ut-robotics/picr22-team-teletupsud/(threads)

Thread 2 (2022-09-19):

[Mechanics] Use circle or arc for slide C-ramp

maidlam, 2022-09-19:
Do not use a spline for the C-ramp of the slide. Use a circle or arc, with its center set on the center of the motor.

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

KaarelJ98, 2022-09-21:
Resolved

Closed 2022-09-24.

Thread 3 (2022-09-19):

[Mechanics] Add wheels and top plate to assembly

maidlam, 2022-09-19:
Add the wheels and top plate to the model so the distance from the floor to the thrower motor and ramps can be checked.

KaarelJ98, 2022-09-22:
Resolved

Closed 2022-09-24.

Thread 5 (2022-09-19):

[Mechanics] Wrong material thickness for slides

maidlam, 2022-09-19:
The slides should be 4,8 mm thick.

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

KaarelJ98, 2022-09-21:
Resolved

Closed 2022-09-24.

Thread 7 (2022-09-25):

[Mechanics] mounting hole size wrong

Akustav, 2022-09-25:
Mounting holes are currently 3mm. They should be 2.5mm

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

KaarelJ98, 2022-09-25:
Resolved

Thread 8 (2022-09-25):

[Mechanics] bottom plate-thrower mating weird

Akustav, 2022-09-25:
Seems like there is some interference between the thrower tabs and the thower:

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

It also seems that the mounting holes are weirdly placed and not centered:
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

KaarelJ98, 2022-09-25:
Resolved

Closed 2022-10-17.

Thread 9 (2022-09-29):

[Mechanics] Test thrower CAM issues

maidlam, 2022-09-29:
Drill:

- Remove dogbones from drill operation

2D Contour

- Under the Passes tab, add Stock to leave based on Pocket part of guide
https://ut-robotics.github.io/picr22-home/basketball_robot_guide/mechanics/cam.html#_pocket
- Under Linking tab, untick Ramp

Closed 2022-12-04.

Thread 11 (2022-10-17):

[Mechanics] add lips for better roller centering

Akustav, 2022-10-17:
I suggest adding lips to the sides of the slots where rollers are. This fixes them better in place.
One thing to keep in mind is that they should only touch the inner sleeve of the bearing since it is static, if it touches other areas, it can

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

KaarelJ98, 2022-10-24:
Resolved

Closed 2022-11-30.

Thread 12 (2022-10-17):

[Mechanics] Wheel screw question

Akustav, 2022-10-17:
Depending on if you plan to cover the wheels or not I suggest using countersunk screw heads. This reduces the chance of damaging opponents or the field with the screwheads.

KaarelJ98, 2022-10-24:
I haven't decided yet if I plan to cover the wheels or not but if not then I will use countersunk screw heads.

Closed 2022-11-30.

Thread 13 (2022-10-17):

[Mechanics] motor-wheel mount issues

Akustav, 2022-10-17:
I suggest making the mount a little thinner.

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

I would make the threaded parts (marked with number 1) around 3mm and the upper part around 8 mm.

Also, the holes in the mount should be 2.5mm instead of 3 since they are threaded.

What screw do you plan to use to fasten the wheel to the motor shaft?

KaarelJ98, 2022-10-24:
Resolved
I was planning to use M4x6 or M4x8 screw.

Closed 2022-11-30.

Thread 14 (2022-10-17):

[Mechanics] add hole for shaft in wheel body

Akustav, 2022-10-17:
Consider adding a hole to the wheel body where the shaft can go. This allows to you more adaptability on where the wheel sits on the shaft.

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

KaarelJ98, 2022-10-24:
Resolved

Closed 2022-11-30.

Thread 16 (2022-10-19):

MCU encoder pins assigned incorrectly

ReikoR, 2022-10-19:
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

PA8 and PA9 are connected to timer 1.
M1_ENC_2 should be connected to PA9 instead of PB7.

PB0 does not have any timer channels that can be used in encoder mode.
For example timer 4 and pins PB6 and PB7 could be used for one of the encoders.

ReikoR, 2022-11-19:
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

Rechecked the pin assignment. PB0 does not have any encoder inputs available (timer channel 1 or 2).

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

Thread 17 (2022-10-19):

Incorrect NRST capacitor value

ReikoR, 2022-10-19:
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

1K(F?) is not a correct value for a 0603 capacitor.
It should probably be 100n.

Closed 2022-10-29.

Thread 23 (2022-10-19):

CM1223 in incorrect package

ReikoR, 2022-10-19:
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

CM1223-**02SR** is in SOT143-4 package.

In the lab we have CM1223-**02SO**, which is in SOT23-5 package.

From [datasheet](https://www.onsemi.com/pdf/datasheet/cm1223-d.pdf):
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

Closed 2022-10-29.

Thread 24 (2022-10-19):

DRV8243 incorrect current limiting

ReikoR, 2022-10-19:
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

From [datasheet](https://ut-robotics.github.io/picr22-home/basketball_robot_guide/electronics/drv8243-q1_datasheet_2021-08.pdf):
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

When ITRIP pin is connected to ground, then current regulation is disabled.

Current limit should be set to around 2-3A to help prevent motor from overheating. IPROPI resistor value should be calculated based on that.

ReikoR, 2022-10-29:
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

Connecting ITRIP pin to 100k resistor sets ITRIP voltage to 2.64 V:
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

Using 10k IPROPI resistor sets current limit to 2.64 V / 10000 ohm * 3070 = 0.81 A, which might be too low to accelerate the motor under load.

Also connecting 100k resistor to SR pin sets the slew rate to highest value:
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

This can't be read form the datasheet, but highest slew rate caused problems last year with motors not starting or rotating properly. Using slew rates of 23 or 28 V/usec worked fine.

Closed 2022-11-02.

Thread 25 (2022-10-19):

Use 4 layers instead of 2

ReikoR, 2022-10-19:
4 layer PCB with both inner layers being grounds is much better for signal integrity.

If there are gaps in ground (or any other reference layer), then return currents have to go around the gaps and electromagnetic fields will spread out more causing more crosstalk.

Also, if distance between signal and reference plane is bigger then fields will spread out more and cause more crosstalk.
In 4-layer PCB, distances between layers 1-2 and 3-4 are usually small (0.2mm or less).

More detailed design advice:
https://www.protoexpress.com/blog/best-high-speed-pcb-routing-practices/

Also, from JLCPCB both 2-layer and 4-layer PCBs up to 50x50mm size cost the same.

ReikoR, 2022-10-29:
Internal planes need to be split to separate MCU side from drivers side. Nets need to assigned to planes.

This short video can be helpful:
https://youtu.be/1XJzsImG-bo?t=70

ReikoR, 2022-11-12:
Correct nets have not been assigned to split planes:
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

ReikoR, 2022-11-16:
PGND net needs to be selected on motor drivers side:
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

And GND net on MCU side:
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

Closed 2022-11-18.

Thread 26 (2022-10-19):

Keep isolated sides completely separate

ReikoR, 2022-10-19:
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

There should be separate grounds on MCU side and drivers side.

General layout should look something like this:
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

ReikoR, 2022-10-29:
MCU side components need to be moved to other side of the board and internal planes need to be split below the isolators.
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

Closed 2022-11-12.

Thread 27 (2022-10-29):

Thrower PWM should go through isolator

ReikoR, 2022-10-29:
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

Motor driver DRVOFF pin can be connected to GND to have driver constantly enabled, instead of connecting it to MCU. Then additional isolator is not needed for thrower PWM.

Thread 29 (2022-10-29):

Use wide polygons or tracks for high currents

ReikoR, 2022-10-29:
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

0.254 mm wide traces can carry about 1.7 A of current at 20 degrees temperature rise:
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

Wider copper helps to carry more current and more copper helps with cooling.

ReikoR, 2022-11-02:
Use wide polygons for higher currents.
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

ReikoR, 2022-11-12:
1. GND pad should also be connected with multiple vias.
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

2. Use "Pour Over All Same Net Objects" in polygon properties.
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
\
And check "Remove Dead Copper".
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

3. Remove vias from motor driver footprint. Vias should not be added to footprints. Currently in motor driver output pads they are not needed. Add vias manually to VM and GND pads after removing them from the footprint.
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

4. Some motor driver capacitors are not connected to PGND.
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

5. Put all the motor driver capacitors in a single row.
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
Something like this:
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

6. Route as much as possible on top layer to prevent making big gaps in 16V polygon.
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

7. Connect capacitor ground pads with PGND polygon on bottom layer.
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

ReikoR, 2022-11-18:
1. Connect motor driver +16V and PGND pads with multiple vias. One via can carry roughly 1 A of current.
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

2. Motor driver output polygons are not aligned with the pads.
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

3. Place smaller capacitors closest to the motor drivers.
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

4. Connect PGND polygon on bottom layer to battery PGND pad vias.
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

ReikoR, 2022-11-19:
Try to place vias more evenly. All the vias don't have to be in the capacitor pads.
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

For example:
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

You can use `Ctrl + Arrow` to move selected items by grid step or `Ctrl + Shift + Arrow` to move them by 10x grid step.

Closed 2022-11-19.

Thread 30 (2022-10-29):

Use smaller vias

ReikoR, 2022-10-29:
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

Smaller vias take less space.
JLCPCB minimum via size is 0.2/0.45 mm.
For higher currents use multiple small vias.

ReikoR, 2022-11-12:
Some vias have the same Diameter and Hole Size:
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

Closed 2022-11-18.

Thread 31 (2022-10-30):

Mounting holes

ReikoR, 2022-10-30:
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

What size screws are you planning to use for attaching the PCB?
2.6mm hole would allow M2.5 or M2 screws to be used, but it might be better to use M3 screws and make the holes bigger.

Holes might be too close for components and tracks. Depending on the screws, they might not fit or might damage tracks on the PCB.
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

ReikoR, 2022-11-02:
Mounting holes are still close to tracks and components:
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

ReikoR, 2022-11-12:
Bottom left hole is a bit too close to motor driver output pad:
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

ReikoR, 2022-11-18:
Don't connect mounting holes to any nets.
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

And don't use plating:
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

ReikoR, 2022-11-19:
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

Bottom right hole is not on 1 mm grid.

Also it might be useful to have holes positioned symmetrically. Right now the y-direction spacing is different from x-direction spacing:
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

ReikoR, 2022-11-19:
If spacers are going to be used then the capacitors at the bottom are too close to the mounting holes.
Capacitors should be moved slightly inwards.

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

Closed 2022-11-19.

Thread 33 (2022-10-30):

0603 package for 10u 25V+ capacitors too small

ReikoR, 2022-10-30:
10u 25V 0603 capacitors exist, but are more expensive. 0805 package size would be better.

Thread 35 (2022-10-30):

Place decoupling capacitors as close as possible to power pins

ReikoR, 2022-10-30:
Capacitors should have shortest possible connection to power pins to reduce inductance. Placing capacitors on the same layer as the component also allows for shorter connection.

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

ReikoR, 2022-11-02:
Decoupling capacitors are still not close to the power pins.

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

ReikoR, 2022-11-12:
100 nF capacitors should be next to the power pins, 4.7uF capacitor can be a bit further away.
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

Closed 2022-11-16.

Thread 36 (2022-11-12):

Use JLC7628 stackup

ReikoR, 2022-11-12:
Use JLC7628 stackup instead of JLC3313 as it is cheaper.

USB differential pair trace width and spacing needs to be changed.

For example 8 mil (about 0.2 mm) trace space and 10.28 mil (about 0.26 mm) trace width would work:
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

ReikoR, 2022-11-18:
Try to make tracks straighter:
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

ReikoR, 2022-11-19:
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

I'm not sure if it is actually better, but it aligns with the recommendations/example layouts:

Example layout of ESD protection component with same pinout as CM1223-02SO:
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

Image taken from here:
https://www.we-online.com/catalog/media/o109030v410%20AppNotes_ANP002_TheProtectionOfUSB20Applications_EN.pdf

In theory there be might some coupling between same signal track segments or the ESD spike might jump the gap.
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

Closed 2022-11-19.

Thread 37 (2022-11-12):

Incorrect voltage regulator footprint

ReikoR, 2022-11-12:
NCP164CSN330T1G:
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

NCV8730ASN500T1G
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

From NCP164 datasheet:
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

ReikoR, 2022-11-16:
3D model is misaligned:
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

Closed 2022-11-18.

Thread 38 (2022-11-12):

Create Board Outline Clearance rule

ReikoR, 2022-11-12:
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

Closed 2022-11-16.

Thread 39 (2022-11-12):

Prefer tented vias

ReikoR, 2022-11-12:
Untented vias can cause shorts or soldering problems in some cases.

Simplest way to use tented vias is to create new Solder Mask Expansion rule:
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

Closed 2022-11-16.

Thread 40 (2022-11-12):

Voltage regulators have EN pins incorrectly connected

ReikoR, 2022-11-12:
1. NCP164:
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
\
Capacitor (C1) must be connected to IN and GND pins.
EN pin must be connected to IN pin to enable the regulator.
\
From [NCP164 datasheet](https://www.onsemi.com/pdf/datasheet/ncp164-d.pdf):
**EN** - Chip enable: Applying V<sub>EN</sub> < 0.2 V disables the regulator, Pulling V<sub>EN</sub> > 0.7 V enables the LDO

2. NCV8730
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
\
Capacitor (C27) must be connected to IN and GND pins.
EN pin must be connected to IN pin or left unconnected to enable the regulator.
Connecting EN pin to IN pin is recommended for compatibility with other regulators.
\
From [NCV8730 datasheet](https://www.onsemi.com/pdf/datasheet/ncv8730-d.pdf):
**EN** - Enable input pin (high − enabled, low − disabled). If this pin is connected to IN pin or if it is left unconnected (pull−up resistor is not required) the device is enabled.

ReikoR, 2022-11-16:
GND is not connected to NCP164:
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

Closed 2022-11-18.

Thread 42 (2022-11-12):

USB connector might be too far away from the edge

ReikoR, 2022-11-12:
PCB edge is marked on the footprint:
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

There is no 3D model on the footprint, so it's hard to say if the connector will collide with the PCB.

From [connector drawing](https://cdn.amphenol-cs.com/media/wysiwyg/files/drawing/10118193.pdf):
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

Closed 2022-11-16.

Thread 43 (2022-11-12):

MCU 3D model is not correctly placed on the footprint

ReikoR, 2022-11-12:
From top of the PCB:
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

From bottom of the PCB:
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

Closed 2022-11-16.

Thread 45 (2022-11-18):

Avoid routing +3V3 on top layer

ReikoR, 2022-11-18:
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

There is a +3V3 polygon on bottom layer.

Connect +3V3 on top layer with vias to polygon on bottom layer, instead of routing it on the top layer.

ReikoR, 2022-11-19:
Place vias closer to components. Capacitors could also be closer.

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

Closed 2022-11-19.

Thread 47 (2022-11-18):

Improve routing

ReikoR, 2022-11-18:
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

Gloss Selected functionality might be useful:
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

Make sure that the tracks to not get too close to each other to prevent noise caused by adjacent tracks.

ReikoR, 2022-11-19:
Try to clean up the layout as much as possible.
Place vias and and capacitors close to components.
Make tracks short and straight.
Keep the space between tracks to prevent signals coupling to adjacent tracks and causing crosstalk.
Try to avoid tracks crossing each other and having to use vias to route across tracks.

For example:
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

It would be better to route nSLEEP track away from high current connections to reduce noise.
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

ReikoR, 2022-11-19:
Some vias can be closer to components.
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

Closed 2022-11-19.

Thread 48 (2022-11-19):

Number and label connectors

ReikoR, 2022-11-19:
It would be useful to number encoder connectors similar to motor drivers and label the other connectors.

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

ReikoR, 2022-11-19:
Increase the text height to  make it readable.
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

Also using Arial font results in lower text height. Text Height parameter needs to be increased to compensate.
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

Try to follow JLCPCB recommendations:
> Minimum Line Width 6 mil (0.153mm)
> Minimum text height 40 mil (1.0mm)

https://jlcpcb.com/capabilities/pcb-capabilitiesJLCPCB

Closed 2022-11-19.

Thread 50 (2022-11-26):

Camera mount holes wrong size and could be interfer

Akustav, 2022-11-26:
The current mounting holes are all 2.5 mm. Do you plan to thread everything?

Also could screw head sizes become an issue?

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

KaarelJ98, 2022-11-27:
The stands should actually have 3mm holes, fixed them. I think the screws will fit, if not then I can drill the holes a bit to the left.

Closed 2022-11-30.

Thread 52 (2022-11-26):

Is there a whole body assembly

Akustav, 2022-11-26:
IS there an assembly where the body, thrower and camera mount are together? Would help with checking the camera location.

Closed 2022-11-30.

Thread 53 (2022-11-30):

Camera FOV cone top not parallel to ground

Akustav, 2022-11-30:
This might make it hard to see what is happening at a distance. Baskets might be harder to see. Did you consider it?

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

KaarelJ98, 2022-12-04:
Adjusted the camera mount angle by a few degrees. It's better now.

maidlam, 2022-12-04:
The FOV cone has a vertical angle of 40 degrees.
Actual vertical angle for the sensor is 42 degrees.

The actual view will be slighty above the ground parllel.
@Akustav would this cause any major issues?

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

Thread 54 (2022-11-30):

No mounting holes for thrower

Akustav, 2022-11-30:
How to you plan to fasten the thrower?

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

KaarelJ98, 2022-12-02:
I was thinking of fastening it from the top with 2 screws, since it can't move anyway because it is between top and bottom plate. Top and bottom plate will be fixed in place with screws in different places.

maidlam, 2022-12-04:
Adding bolts to the bottom might be a good idea.

During one test competition, the bottom plate of a robot came off from around a motor mount (no bolts were used). The robot didn't behave as expected then.

The bottom plate coming off from around the thrower could also cause issues.

KaarelJ98, 2022-12-04:
No problem, I'll add the holes for screws. Easy fix.

Thread 56 (2022-12-04):

Front wheels close to top plate wheel wells

maidlam, 2022-12-04:
The front wheels are very close to the edges of the wheel wells - 0,6 mm distance between the rollers and plate.
Increase the distance by a mm or two.

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

KaarelJ98, 2022-12-04:
Fixed

Thread 57 (2022-12-04):

Sharp corners in bottom plate

maidlam, 2022-12-04:
Add a slight fillet to sharp corners of the bottom plate.

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

KaarelJ98, 2022-12-04:
Fixed

Thread 58 (2022-12-04):

Battery holders block battery wires

maidlam, 2022-12-04:
The wires of the battery come out at the corner of the battery.

The inside corners of the holders will block those wires.

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

KaarelJ98, 2022-12-04:
Possibly fixed now.
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

Thread 60 (2023-01-04):

Mainboard documentation

ReikoR, 2023-01-04:
1. Documentation should be in [electronics/README.asciidoc](https://github.com/ut-robotics/picr22-team-teletupsud/blob/electronics/electronics/README.asciidoc), not in [README.asciidoc](https://github.com/ut-robotics/picr22-team-teletupsud/blob/electronics/README.asciidoc).

2. Under functionality describe how many and what type of motors and at which voltages and currents the board can control.
Example functionality description can be seen here: https://github.com/ReikoR/MC33886_driver_board/blob/master/README.asciidoc

3. Programmer connector pinout is incorrect.
\
On the schematic:
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
\
In README:
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

4. There is no need to describe USB connector pinout as it's standardised.

5. J10 is thrower connector not motor 1 encoder connector.
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
\
Unused pins (3 and 4) can be documented as NC (not connected).

ReikoR, 2023-01-05:
2. This is not really correct:
_"These motors need 12V and 5.5A to work properly. However, DRV8243 is capable with 40V and output 12 amps."_
\
12V is nominal voltage. 5.5A is stall current at 12V.
These motors work properly at lower power and at different voltage.
Usually the max power needs to be limited to avoid damaging the motor.
Recommended max power is only 12W, but we run them at an higher power to get more performance at the cost of damaging them.
https://www.pololu.com/category/116/37d-metal-gearmotors
\
There is not really need to describe specific motors.
Mainboard capabilities should just describe output voltage and current.
\
Voltage for the motor drivers is limited by the voltage rating (25V) of the motor driver VM capacitors. It safe to say that maximum input voltage can be 16.8V (4S battery) to have some margin below 25V. Current is limited by the motor driver configuration resistors. This current limit should be added to the README. Also the motor drivers are pre-production variants, which have maximum current limit at 9A, but it's not important to specify that if current limit is configured to be lower.
\
From [datasheet](https://ut-robotics.github.io/picr22-home/basketball_robot_guide/electronics/drv8243-q1_datasheet_2021-08.pdf):
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

3. Programmer connector pinout is still incorrect. Pin 9 needs to be GND and pin 10 is missing.
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

ReikoR, 2023-01-07:
3. Pin 9 is GND, not NC.
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

6. Format "Connector pinouts:" as a title.
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

Closed 2023-01-10.
