ut-robotics/picr22-team-teletupsud/electronics/Source files/Teletupsud-Schematic.pdf

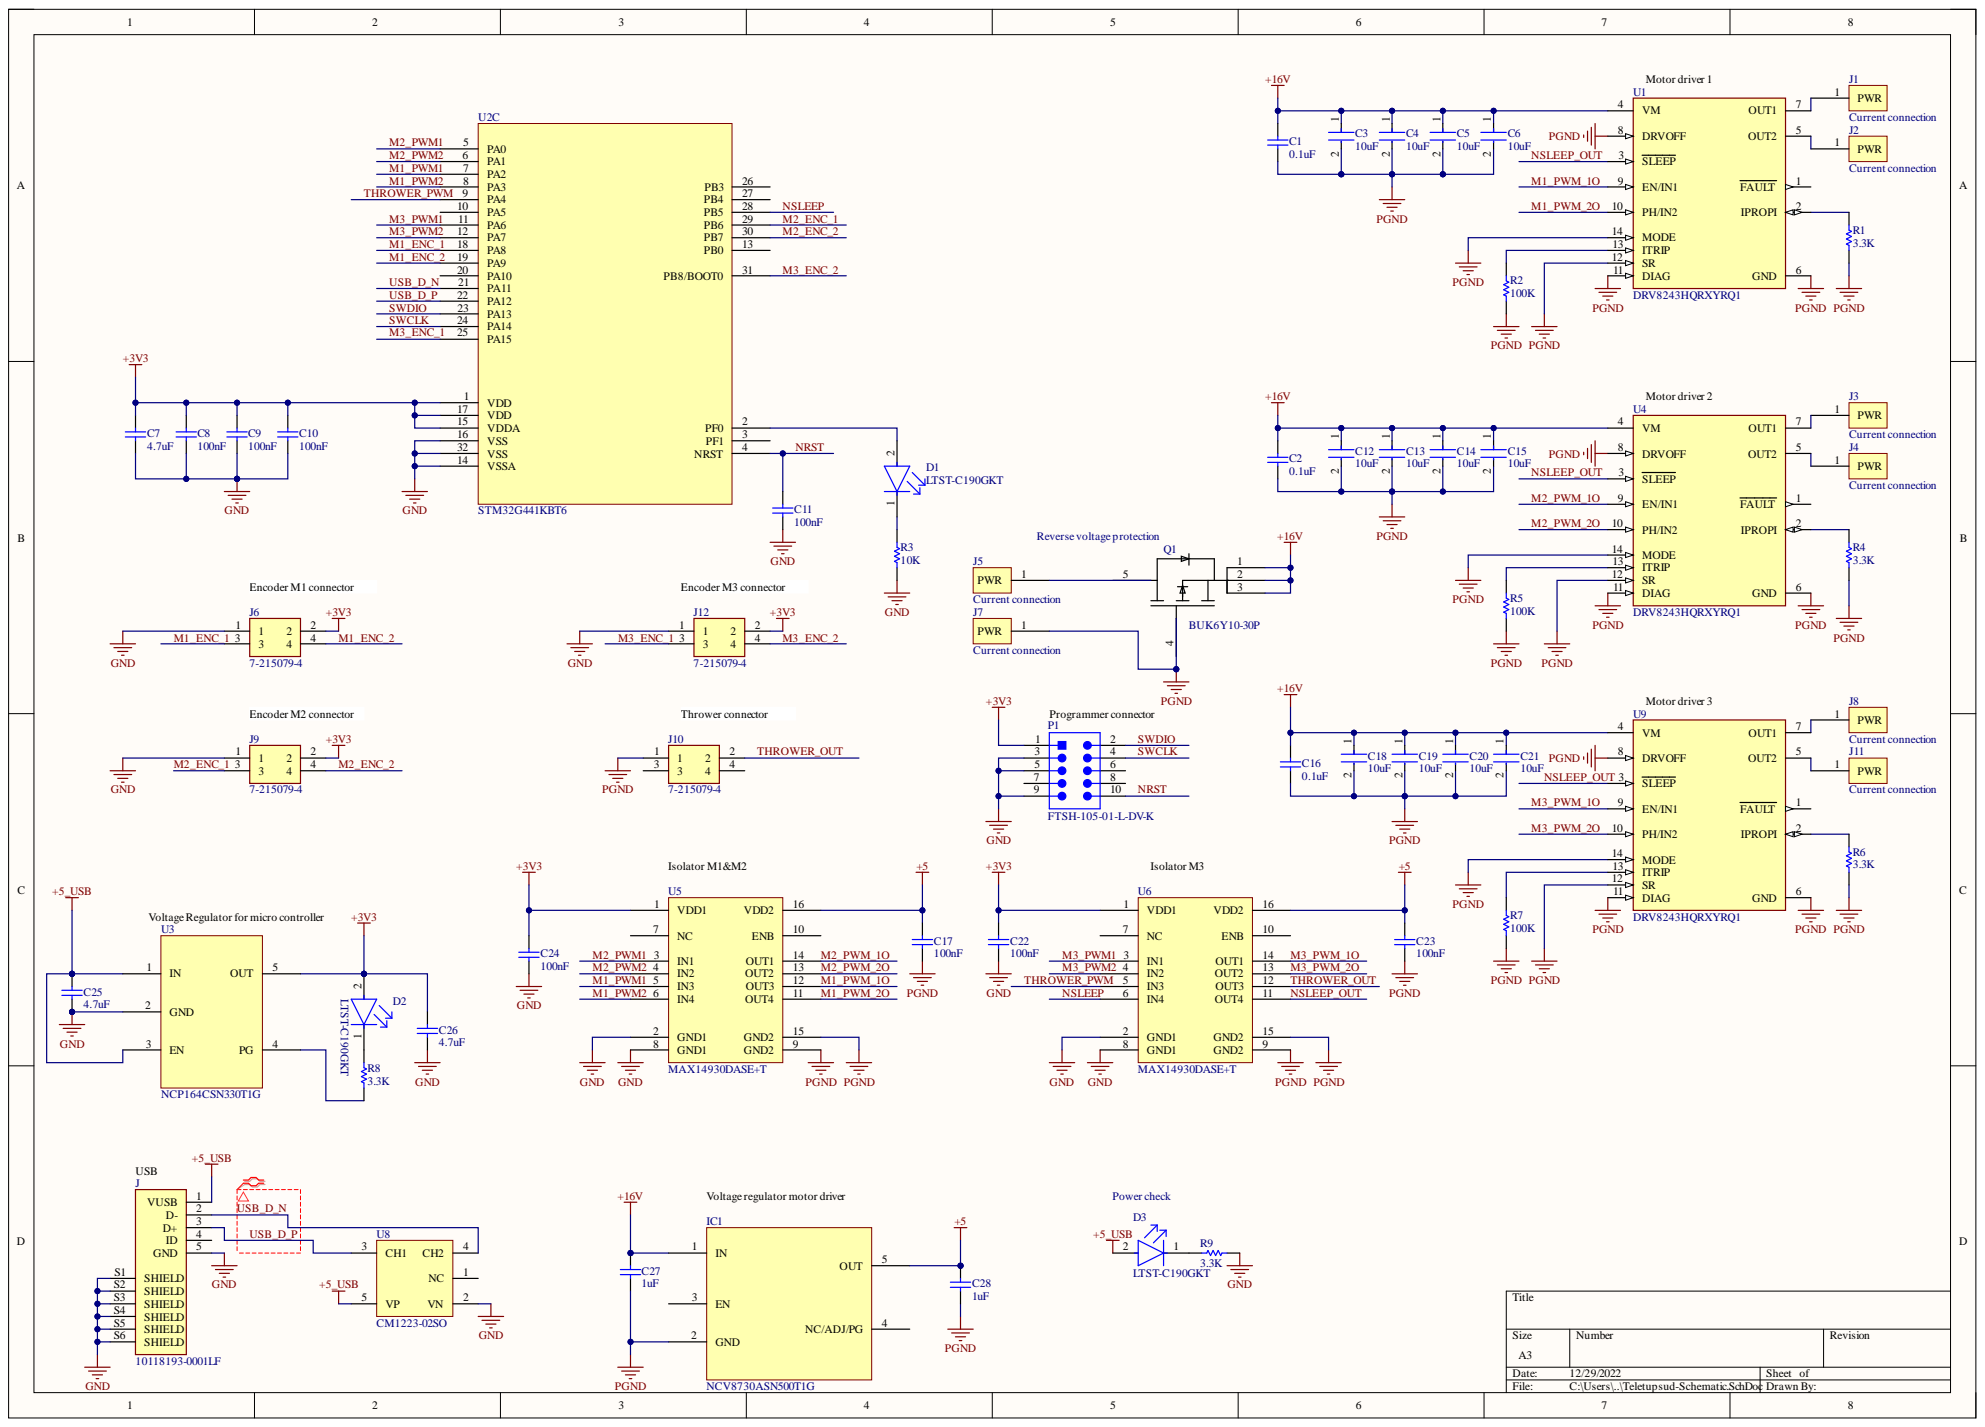
[picture p8: page 1]

VoltageRegulator for micro controller

Voltage regulator motor driver
