ut-robotics/picr22-team-teletupsud/(list of files, drawings)

Other design files:
electronics/Source files/PICR22-team-Teletupsud1.PrjPcb
electronics/Source files/Teletupsud-PCB.PcbDoc
electronics/Source files/Teletupsud-Schematic.SchDoc
