ut-robotics/picr22-team-teletupsud/firmware/Core/Src/main.c

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
/* Includes ------------------------------------------------------------------*/
#include "main.h"
#include "usb_device.h"

/* USER CODE BEGIN Includes */
#include "usbd_cdc_if.h" // (1)
/* USER CODE END Includes */

TIM_HandleTypeDef htim1;
TIM_HandleTypeDef htim2;
TIM_HandleTypeDef htim3;
TIM_HandleTypeDef htim4;
TIM_HandleTypeDef htim6;
TIM_HandleTypeDef htim8;
TIM_HandleTypeDef htim16;
TIM_HandleTypeDef htim17;

void SystemClock_Config(void);
static void MX_GPIO_Init(void);
static void MX_TIM1_Init(void);
static void MX_TIM2_Init(void);
static void MX_TIM3_Init(void);
static void MX_TIM4_Init(void);
static void MX_TIM8_Init(void);
static void MX_TIM16_Init(void);
static void MX_TIM17_Init(void);
static void MX_TIM6_Init(void);
/* USER CODE BEGIN 0 */

typedef struct __attribute__((__packed__)) Command {
  int16_t speed1;
  int16_t speed2;
  int16_t speed3;
  uint16_t throwerspeed;
  uint16_t delimiter;
} Command;
Command command = {
	.speed1 = 10,
	.speed2 = 10,
	.speed3 = 10,
	.throwerspeed = 0,
	.delimiter = 0
};
typedef struct Motors{
	int16_t PIDP;
	int16_t PIDI;
	int16_t PIDD;
	int32_t integral;
	int16_t poschange;
	int16_t pos;
}Motors;
Motors Motor1 = {.pos = 0, .poschange = 0, .PIDP = 2000, .PIDI = 20, .PIDD = 0, .integral = 0};
Motors Motor2 = {.pos = 0, .poschange = 0, .PIDP = 2000, .PIDI = 20, .PIDD = 0, .integral = 0};
Motors Motor3 = {.pos = 0, .poschange = 0, .PIDP = 2000, .PIDI = 20, .PIDD = 0, .integral = 0};

typedef struct __attribute__((__packed__)) Feedback {
  int16_t speed1;
  int16_t speed2;
  int16_t speed3;
  uint16_t delimiter;
} Feedback;

Feedback feedback = { // (1)
	.speed1 = 0,
	.speed2 = 0,
	.speed3 = 0,
	.delimiter = 0xAAAA
  };

volatile uint8_t isCommandReceived = 0; // (5)

void CDC_On_Receive(uint8_t* buffer, uint32_t* length) { // (6)
  if (*length == sizeof(Command)) { // (7)

    memcpy(&command, buffer, sizeof(Command)); // (8)
    if (command.delimiter == 0xAAAA) { // (9)
      isCommandReceived = 1;
    }
  }
}
void enc_start(){
	  HAL_TIM_Encoder_Start(&htim1, TIM_CHANNEL_1 | TIM_CHANNEL_2); //Motor 1
	  HAL_TIM_Encoder_Start(&htim4, TIM_CHANNEL_1 | TIM_CHANNEL_2); //Motor 2
	  HAL_TIM_Encoder_Start(&htim8, TIM_CHANNEL_1 | TIM_CHANNEL_2); //Motor 3
}
void pwm_start(){
  HAL_TIM_PWM_Start(&htim2, TIM_CHANNEL_3); // Motor 1
  HAL_TIM_PWM_Start(&htim2, TIM_CHANNEL_1); //Motor 2
  HAL_TIM_PWM_Start(&htim16, TIM_CHANNEL_1); //Motor 3
  HAL_TIM_PWM_Start(&htim3, TIM_CHANNEL_2); //Thrower
  TIM2->CCR3 = 0; //1
  TIM2->CCR1 = 0;//2
  TIM16->CCR1 = 0;//3
  TIM3->CCR2 = 2800;//thrower value that it boots up(2 beeps) in the beginning
}

uint16_t thrower_calculation(uint16_t value, uint16_t min, uint16_t max) { //Function for thrower values, so the speed won't go below or above the limit 
	if (value > max) {
		return max;
	}else if (value < min) {
		return min;
	}
	return value;
}

int16_t clamp16(int16_t value, int16_t min, int16_t max){
	if (value<min){
		return min;
	}
	if(value > max){
		return max;
	}
	return value;

}
int32_t clamp32(int32_t value, int32_t min, int32_t max){
	if (value<min){
		return min;
	}
	if(value > max){
		return max;
	}
	return value;

}
void WakingDriversUp(){ //Just sending nsleep signal pulse to the motor drivers

	HAL_GPIO_WritePin(GPIOB, NSLEEP_Pin, GPIO_PIN_RESET);
	for(uint16_t i = 0; i < 300; i++) {
		__asm("nop");
	}
	HAL_GPIO_WritePin(GPIOB, NSLEEP_Pin, GPIO_PIN_SET);
}

int32_t MotorsC(Motors* motor, int16_t pos, int16_t speed) {

	motor->poschange = (pos-motor->pos); //Calculating position change
	int16_t error = (speed-motor->poschange); //Calculating error

	if (speed == 0) { //If speed is 0, then set the motor also 0, otherwise they keep spinning
		motor->integral = 0;
	} else {
		motor->integral += error;
		motor->integral=clamp32(motor->integral, -65535/motor->PIDI, 65535/motor->PIDI);
	}

	motor->pos = pos;
	return (int32_t)error*(int32_t)motor->PIDP + (int32_t)motor->PIDI*(int32_t)motor->integral + (int32_t)motor-> poschange*(int32_t)motor->PIDD;

}


void HAL_TIM_PeriodElapsedCallback(TIM_HandleTypeDef *htim) {
    HAL_GPIO_TogglePin(LED_GPIO_Port, LED_Pin);

	int32_t motor1PWM = clamp32(MotorsC(&Motor1, (int16_t)TIM1->CNT, command.speed1), -65535, 65535);//Calculating pwm

	if (motor1PWM < 0) { //Deciding the direction for the motors
		HAL_GPIO_WritePin(GPIOA, M1_DIRECTION_Pin, 1);
	} else {
		HAL_GPIO_WritePin(GPIOA, M1_DIRECTION_Pin, 0);
	}
	int32_t motor2PWM = clamp32(MotorsC(&Motor2, (int16_t)TIM4->CNT, command.speed2), -65535, 65535);
	if (motor2PWM < 0) {
		HAL_GPIO_WritePin(GPIOA, M2_DIRECTION_Pin, 1);
	} else {
		HAL_GPIO_WritePin(GPIOA, M2_DIRECTION_Pin, 0);
	}
	int32_t motor3PWM = clamp32(MotorsC(&Motor3, (int16_t)TIM8->CNT, command.speed3), -65535, 65535);
	if (motor3PWM < 0) {
		HAL_GPIO_WritePin(GPIOA, M3_DIRECTION_Pin, 1);
	} else {
		HAL_GPIO_WritePin(GPIOA, M3_DIRECTION_Pin, 0);
	}
	TIM2->CCR3 = abs(motor1PWM); //Setting motor pwm-s
	TIM2->CCR1 = abs(motor2PWM);
	TIM16->CCR1 = abs(motor3PWM);
}


/* USER CODE END 0 */

/**
  * @brief  The application entry point.
  * @retval int
  */
int main(void)
{
  /* MCU Configuration--------------------------------------------------------*/

  /* Reset of all peripherals, Initializes the Flash interface and the Systick. */
  HAL_Init();

  /* Configure the system clock */
  SystemClock_Config();

  /* Initialize all configured peripherals */
  MX_GPIO_Init();
  MX_USB_Device_Init();
  MX_TIM1_Init();
  MX_TIM2_Init();
  MX_TIM3_Init();
  MX_TIM4_Init();
  MX_TIM8_Init();
  MX_TIM16_Init();
  MX_TIM17_Init();
  MX_TIM6_Init();
  /* USER CODE BEGIN 2 */

 HAL_TIM_Base_Start_IT(&htim6);

  enc_start(); //Starting encoders
  pwm_start(); //Starting pwm
	HAL_GPIO_WritePin(GPIOB, NSLEEP_Pin, GPIO_PIN_SET); //Setting the nsleep pin 

  /* USER CODE END 2 */

  /* Infinite loop */
  /* USER CODE BEGIN WHILE */

  while (1)
  {
    /* USER CODE END WHILE */

    /* USER CODE BEGIN 3 */
	//TIM3->CCR2 = command.throwerspeed +3150;//Updating thrower

    if (isCommandReceived) {
      TIM3->CCR2 = thrower_calculation(command.throwerspeed, 10, 7000);//calling out the
      isCommandReceived = 0;
      feedback.speed1 = Motor1.poschange; //For debbuging
      feedback.speed2 = Motor2.poschange;
      feedback.speed3 = command.throwerspeed;
      WakingDriversUp(); //Sending nsleep signals
      CDC_Transmit_FS(&feedback, sizeof(feedback));  // Send data over USB
    }
  }
  /* USER CODE END 3 */
}

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
