ut-robotics/picr22-team-teletupsud/firmware/Core/Inc/main.h

#define LED_Pin GPIO_PIN_0
#define LED_GPIO_Port GPIOF
#define NRST_Pin GPIO_PIN_10
#define NRST_GPIO_Port GPIOG
#define M2_PWM1_Pin GPIO_PIN_0
#define M2_PWM1_GPIO_Port GPIOA
#define M2_DIRECTION_Pin GPIO_PIN_1
#define M2_DIRECTION_GPIO_Port GPIOA
#define M1_PWM1_Pin GPIO_PIN_2
#define M1_PWM1_GPIO_Port GPIOA
#define M1_DIRECTION_Pin GPIO_PIN_3
#define M1_DIRECTION_GPIO_Port GPIOA
#define THOWER_PWM_Pin GPIO_PIN_4
#define THOWER_PWM_GPIO_Port GPIOA
#define M3_PWM1_Pin GPIO_PIN_6
#define M3_PWM1_GPIO_Port GPIOA
#define M3_DIRECTION_Pin GPIO_PIN_7
#define M3_DIRECTION_GPIO_Port GPIOA
#define M1_ENC_1_Pin GPIO_PIN_8
#define M1_ENC_1_GPIO_Port GPIOA
#define M1_ENC_2_Pin GPIO_PIN_9
#define M1_ENC_2_GPIO_Port GPIOA
#define M3_ENC_1_Pin GPIO_PIN_15
#define M3_ENC_1_GPIO_Port GPIOA
#define NSLEEP_Pin GPIO_PIN_5
#define NSLEEP_GPIO_Port GPIOB
#define M2_ENC_1_Pin GPIO_PIN_6
#define M2_ENC_1_GPIO_Port GPIOB
#define M2_ENC_2_Pin GPIO_PIN_7
#define M2_ENC_2_GPIO_Port GPIOB
#define M3_ENC_2_Pin GPIO_PIN_8
#define M3_ENC_2_GPIO_Port GPIOB
