ut-robotics/picr22-team-teletupsud/software/image_processor.py

import camera
import segment
import _pickle as pickle
import numpy as np
import cv2
import Color as c


class Object():
    def __init__(self, x = -1, y = -1, size = -1, distance = -1, exists = False):
        self.x = x
        self.y = y
        self.size = size
        self.distance = distance
        self.exists = exists

    def __str__(self) -> str:
        return "[Object: x={}; y={}; size={}; distance={}; exists={}]".format(self.x, self.y, self.size, self.distance, self.exists)

    def __repr__(self) -> str:
        return "[Object: x={}; y={}; size={}; distance={}; exists={}]".format(self.x, self.y, self.size, self.distance, self.exists)


# results object of image processing. contains coordinates of objects and frame data used for these results
class ProcessedResults():

    def __init__(self, 
                balls=[], 
                basket_b = Object(exists = False), 
                basket_m = Object(exists = False), 
                color_frame = [],
                depth_frame = [],
                fragmented = [],
                debug_frame = []) -> None:


        self.balls = balls
        self.basket_b = basket_b
        self.basket_m = basket_m
        self.color_frame = color_frame
        self.depth_frame = depth_frame
        self.fragmented = fragmented

        # can be used to illustrate things in a separate frame buffer
        self.debug_frame = debug_frame


#Main processor class. processes segmented information
class ImageProcessor():
    def __init__(self, camera, color_config = "colors/colors.pkl", debug = False):
        self.camera = camera

        self.color_config = color_config
        with open(self.color_config, 'rb') as conf:
            self.colors_lookup = pickle.load(conf)
            self.set_segmentation_table(self.colors_lookup)

        self.fragmented	= np.zeros((self.camera.rgb_height, self.camera.rgb_width), dtype=np.uint8)

        self.t_balls = np.zeros((self.camera.rgb_height, self.camera.rgb_width), dtype=np.uint8)
        self.t_basket_b = np.zeros((self.camera.rgb_height, self.camera.rgb_width), dtype=np.uint8)
        self.t_basket_m = np.zeros((self.camera.rgb_height, self.camera.rgb_width), dtype=np.uint8)

        self.debug = debug
        self.debug_frame = np.zeros((self.camera.rgb_height, self.camera.rgb_width), dtype=np.uint8)

    def set_segmentation_table(self, table):
        segment.set_table(table)

    def start(self):
        self.camera.open()

    def stop(self):
        self.camera.close()

    def analyze_balls(self, t_balls, fragments) -> list:
        contours, hierarchy = cv2.findContours(t_balls, cv2.RETR_EXTERNAL, cv2.CHAIN_APPROX_SIMPLE)

        balls = []

        for contour in contours:

            # ball filtering logic goes here. Example includes filtering by size and an example how to get pixels from
            # the bottom center of the fram to the ball

            size = cv2.contourArea(contour)

            if size < 15:
                continue
            
            x, y, w, h = cv2.boundingRect(contour)

            ys	= np.array(np.arange(y + h, self.camera.rgb_height), dtype=np.uint16)
            xs	= np.array(np.linspace(x + w/2, self.camera.rgb_width / 2, num=len(ys)), dtype=np.uint16)

            obj_x = int(x + (w/2))
            obj_y = int(y + (h/2))
            obj_dst = obj_y
            current_y = obj_y
            last_thing = current_y
            we_are_bing_chilling = False
            black = white = 0
            enough_black = False
            while True:
                #print(f"DING! black :{black}, white :{white}")
                #võtame läbi kõik pikslid mis jäävad palli keskpunkti alla
                current_y +=1
                if current_y == self.camera.rgb_height:
                    break
                #kui leiame musta piksli, siis oleme võibolla leidnud piiri alguse
                if fragments[current_y][obj_x] == 6:
                    #print(f"black - {current_y}")
                    black +=1
                    if black>=6:
                        enough_black = True
                    last_thing = current_y
                
                #kui leiame valge piksli oleme võibolla leidnud piiri teise osa
                elif fragments[current_y][obj_x] == 5:
                    #print(f"white - {current_y}")
                    white +=1
                    if white >=6 and enough_black:
                        #this means we successfully found the border
                        we_are_bing_chilling = True
                        break
                    last_thing = current_y
                #kui piksel pole ei must ega valge, siis  lähme tagasi algusesse, resettime koik            
                ##elif last_thing - current_y >=6:
                  #  white = 0
                   # black = 0
                    #enough_black = False
            
            borderheight = black + white
            #print(f"black : {black}, white : {white}, {current_y},{we_are_bing_chilling}")
            if not we_are_bing_chilling or obj_y > current_y:
                if self.debug:
                    self.debug_frame[ys, xs] = [0, 0, 0]
                    cv2.circle(self.debug_frame,(obj_x, obj_y), 10, (0,255,0), 2)
                balls.append(Object(x = obj_x, y = obj_y, size = size, distance = obj_dst, exists = True))
        balls.sort(key= lambda x: x.size, reverse=True)
        return balls

    def analyze_baskets(self, t_basket, depth, debug_color = (0, 255, 255)) -> list:
        contours, hierarchy = cv2.findContours(t_basket, cv2.RETR_EXTERNAL, cv2.CHAIN_APPROX_SIMPLE)

        baskets = []
        for contour in contours:

            # basket filtering logic goes here. Example includes size filtering of the basket

            size = cv2.contourArea(contour)

            if size < 100:
                continue

            x, y, w, h = cv2.boundingRect(contour)

            obj_x = int(x + (w/2))
            obj_y = int(y + (h/2))
            obj_dst = np.average(depth[obj_y-1:obj_y+1,obj_x-1:obj_x+1])

            baskets.append(Object(x = obj_x, y = obj_y, size = size, distance = obj_dst, exists = True))

        baskets.sort(key= lambda x: x.size, reverse=True)

        basket = next(iter(baskets), Object(exists = False))

        if self.debug:
            if basket.exists:
                cv2.circle(self.debug_frame,(basket.x, basket.y), 20, debug_color, -1)
        return basket
    def get_depth(self,x,y,depth_frame):
        return depth_frame[y][x]
        
    def get_frame_data(self, aligned_depth = False):
        
        if self.camera.has_depth_capability():
            color_frame, depth_frame = self.camera.get_frames(aligned = aligned_depth)
            return color_frame, depth_frame
        else:

            return cv2.flip(cv2.flip(self.camera.get_color_frame(),1),1), np.zeros((self.camera.rgb_height, self.camera.rgb_width), dtype=np.uint8)

    def process_frame(self, aligned_depth = False) -> ProcessedResults:
        color_frame, depth_frame = self.get_frame_data(aligned_depth = aligned_depth)
        color_frame = cv2.rectangle(color_frame,(25,420),(800,480),(125,125,255),-1)
        kernel = np.array([[0,1,0],[1,1,1],[0,1,0]],dtype=np.uint8)
        color_frame = cv2.dilate(color_frame, kernel, iterations=1)
        segment.segment(color_frame, self.fragmented, self.t_balls, self.t_basket_m, self.t_basket_b)

        if self.debug:
            self.debug_frame = np.copy(color_frame)
        
        balls = self.analyze_balls(self.t_balls, self.fragmented)
        basket_b = self.analyze_baskets(self.t_basket_b,depth_frame, debug_color=c.Color.BLUE.color.tolist())
        basket_m = self.analyze_baskets(self.t_basket_m,depth_frame, debug_color=c.Color.MAGENTA.color.tolist())

        return ProcessedResults(balls = balls, 
                                basket_b = basket_b, 
                                basket_m = basket_m, 
                                color_frame=color_frame, 
                                depth_frame=depth_frame, 
                                fragmented=self.fragmented, 
                                debug_frame=self.debug_frame)
