ut-robotics/picr22-team-teletupsud/(commit log)

2022-10-03 fixed some issues from pull request
    [main.py, motion.py]
2022-10-13 Fixed stuttering in place, added basic throwing.
    [main.py, motion.py, test.py]
2022-10-17 Mainboard source files
    [PICR22-team-Teletupsud.PrjPcb, Teletupsud-Schematic.SchDoc]
2022-10-20 fixed issues from pull request, basic basket logic
    [main.py, motion.py, test.py]
2022-10-24 moved throwing logic, thresholding, masking motor
2022-11-01 PCB design
    [PICR22-team-Teletupsud.PrjPcb, Teletupsud-PCB.PcbDoc, Teletupsud-Schematic.SchDoc]
2022-11-01 Fast bugfix
    [Teletupsud-PCB.PcbDoc]
2022-11-02 PrjPCB file
    [PICR22-team-Teletupsud1.PrjPcb]
2022-11-14 Update files
    [Teletupsud-PCB.PcbDoc, Teletupsud-Schematic.SchDoc]
2022-11-17 Design fixes
    [PICR22-team-Teletupsud1.PrjPcb, Teletupsud-PCB.PcbDoc, Teletupsud-Schematic.SchDoc]
2022-11-17 Small bug fix
    [Teletupsud-PCB.PcbDoc]
2022-11-17 Small bug fix again
    [Teletupsud-PCB.PcbDoc]
2022-11-19 Added some text on board
    [Teletupsud-PCB.PcbDoc]
2022-11-19 Some PCB desing fixes and gerber 2x files
    [PICR22-team-Teletupsud1.PrjPcb, Teletupsud-PCB.PcbDoc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]
2022-11-19 Bug fixes
    [PICR22-team-Teletupsud1.PrjPcb, Teletupsud-PCB.PcbDoc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]
2022-11-19 Fixed bug
    [Teletupsud-PCB.PcbDoc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]
2023-01-02 Mainboard and motor driver documentation
    [PICR22-team-Teletupsid-Components.tsv]
2023-01-04 Small BOM fixes
    [PICR22-team-Teletupsid-Components.tsv, PICR22-team-Teletupsud-components.tsv]
2023-01-04 Changed some components links
    [PICR22-team-Teletupsud-components.tsv]
